willburk97/CH4100_SIM7000/46CAF7E9-A68A-448F-A60B-BB5EA6FEE872.jpeg

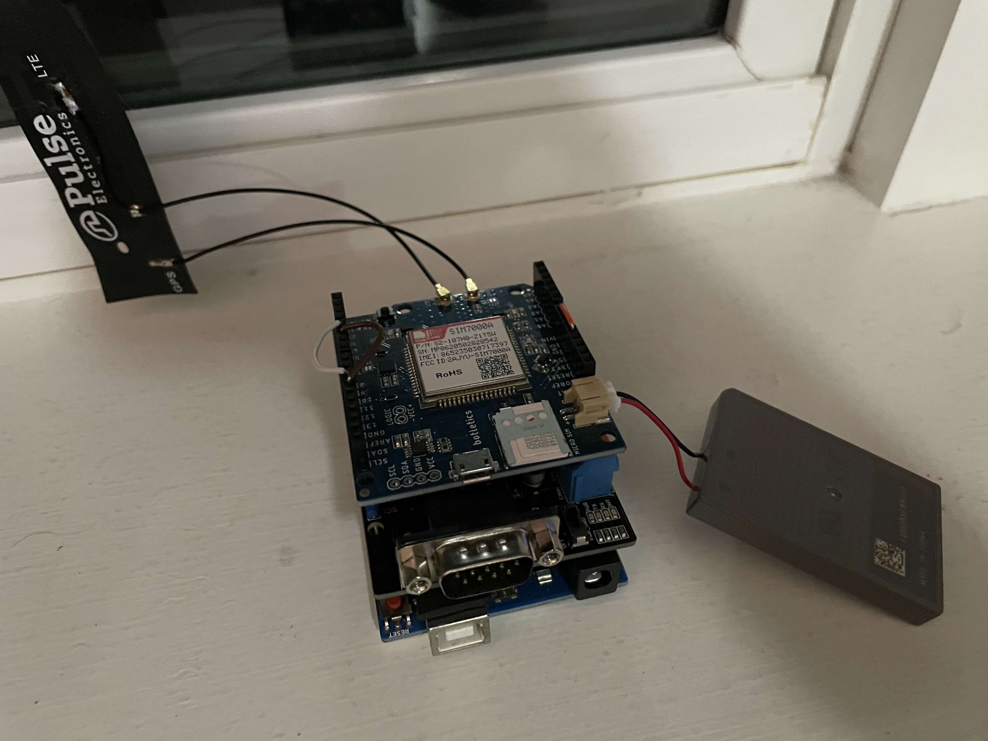
46CAF7E9-A68A-448F-A60B-BB5EA6FEE872.jpeg
