willburk97/CH4100_SIM7000/D7A05859-17FF-4CD3-95CA-90B7D243AB5F.jpeg

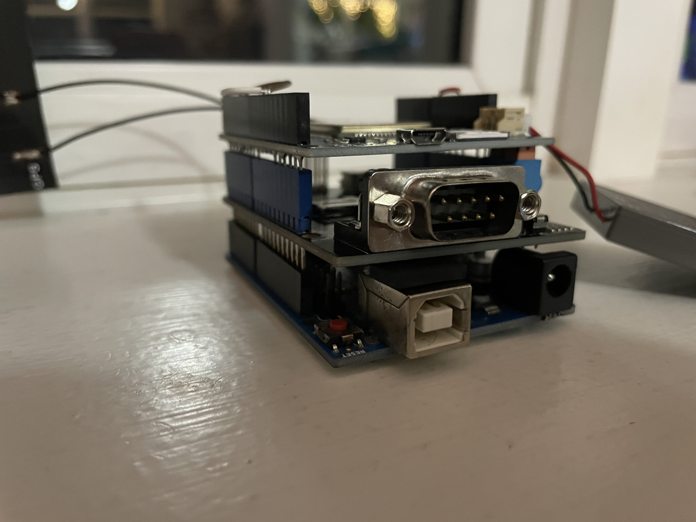
D7A05859-17FF-4CD3-95CA-90B7D243AB5F.jpeg
