willburk97/CH4100_SIM7000/(commit log)

2021-10-28 Updated code with various changes
    Sorry for the mess, wanted to upload an updated version.
    Code updated for Seeed's updated library.
    Various tweaks made to prevent a comm outage from stopping the charging.
    [TCCharger-SIM7000-nocommstop.ino]
2021-10-28 Update README.md
    Added recent updates. Fixed comm outage issue. Fixed SIM7000 battery/power issue (replaced with diode.)
2021-10-28 Cleaned up code a bit
    Recently uploaded my current code but it was pretty messy. Here's a cleaned up version.
2021-10-28 Update README.md
    Adding diode part number to readme.
